joshajohnson/iCE40-feather/(threads)

Thread 1 (2023-09-19):

Looking for the assembly STEP model - can't find it.

paclogic, 2023-09-19:
If you would provide one or show a pointer to one that would be great.

joshajohnson, 2023-09-20:
Hi, you can export a STEP file from the KiCad project.

paclogic, 2023-10-13:
Josh, could you please post the STEP file in a directory so that i don't have to install and learn how to do it in KiCAD. Thank you very much !

Closed 2023-09-20.
