joshajohnson/iCE40-feather/hardware/0.1/iCE40-fpga.pdf

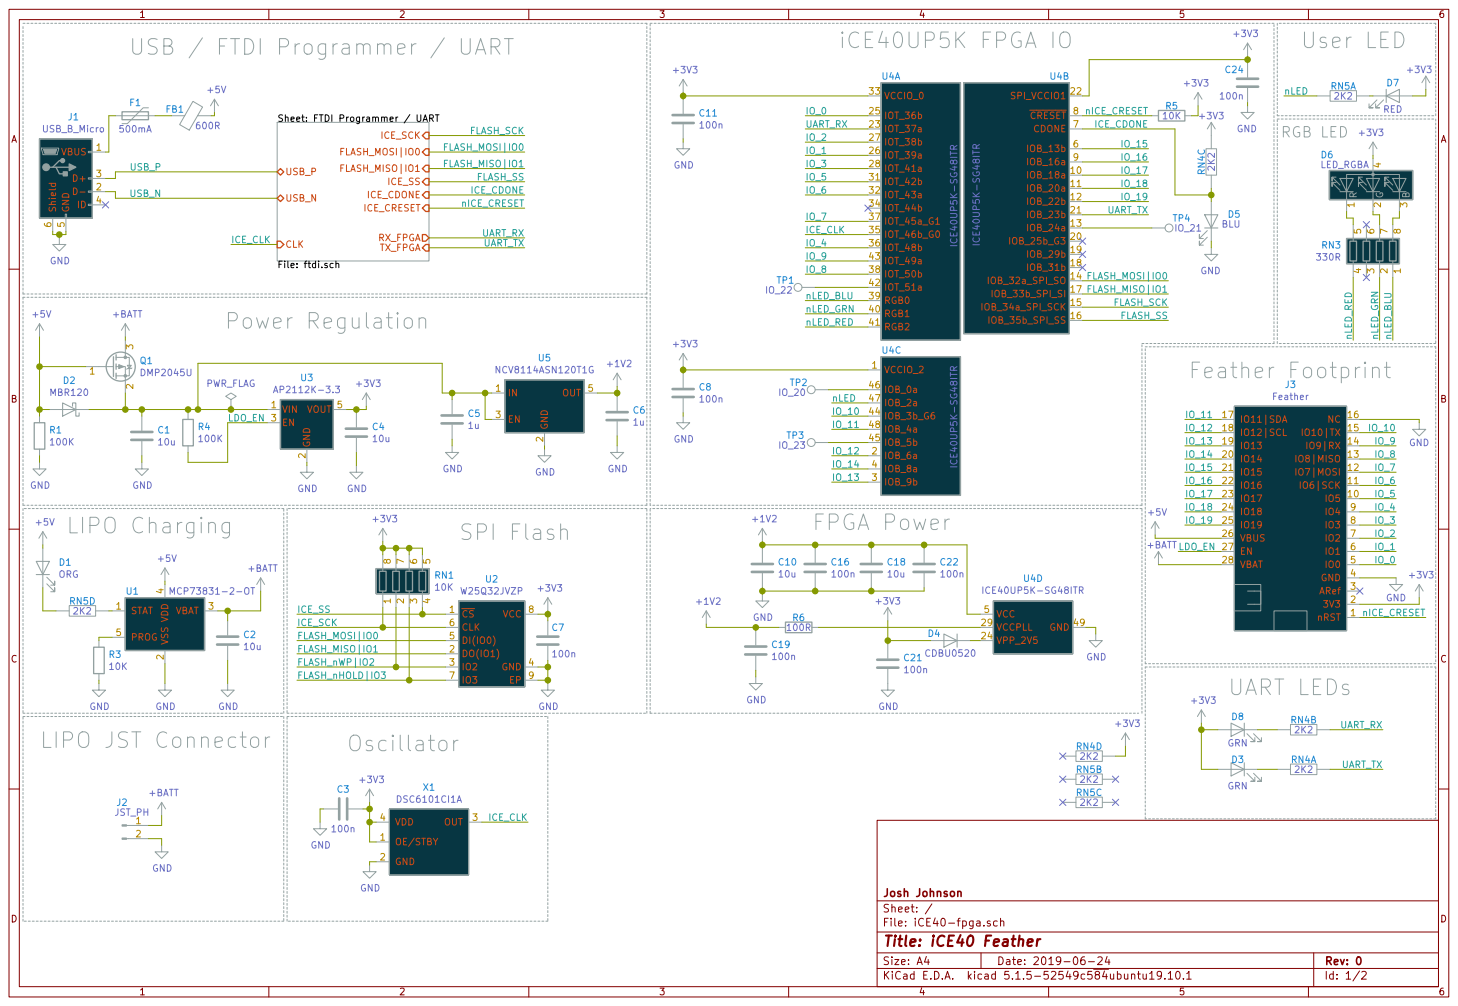
[picture p2: page 1]

USB / FTDI Programmer / UART

Sheet: FTDI Programmer / UART

4 PROG 5 U1 MCP73831-2-OT GND OE/STBY 1 GND 2 OUT 3 VDD 4 X1 DSC6101CI1A

File: iCE40-fpga.sch Sheet: / Josh Johnson

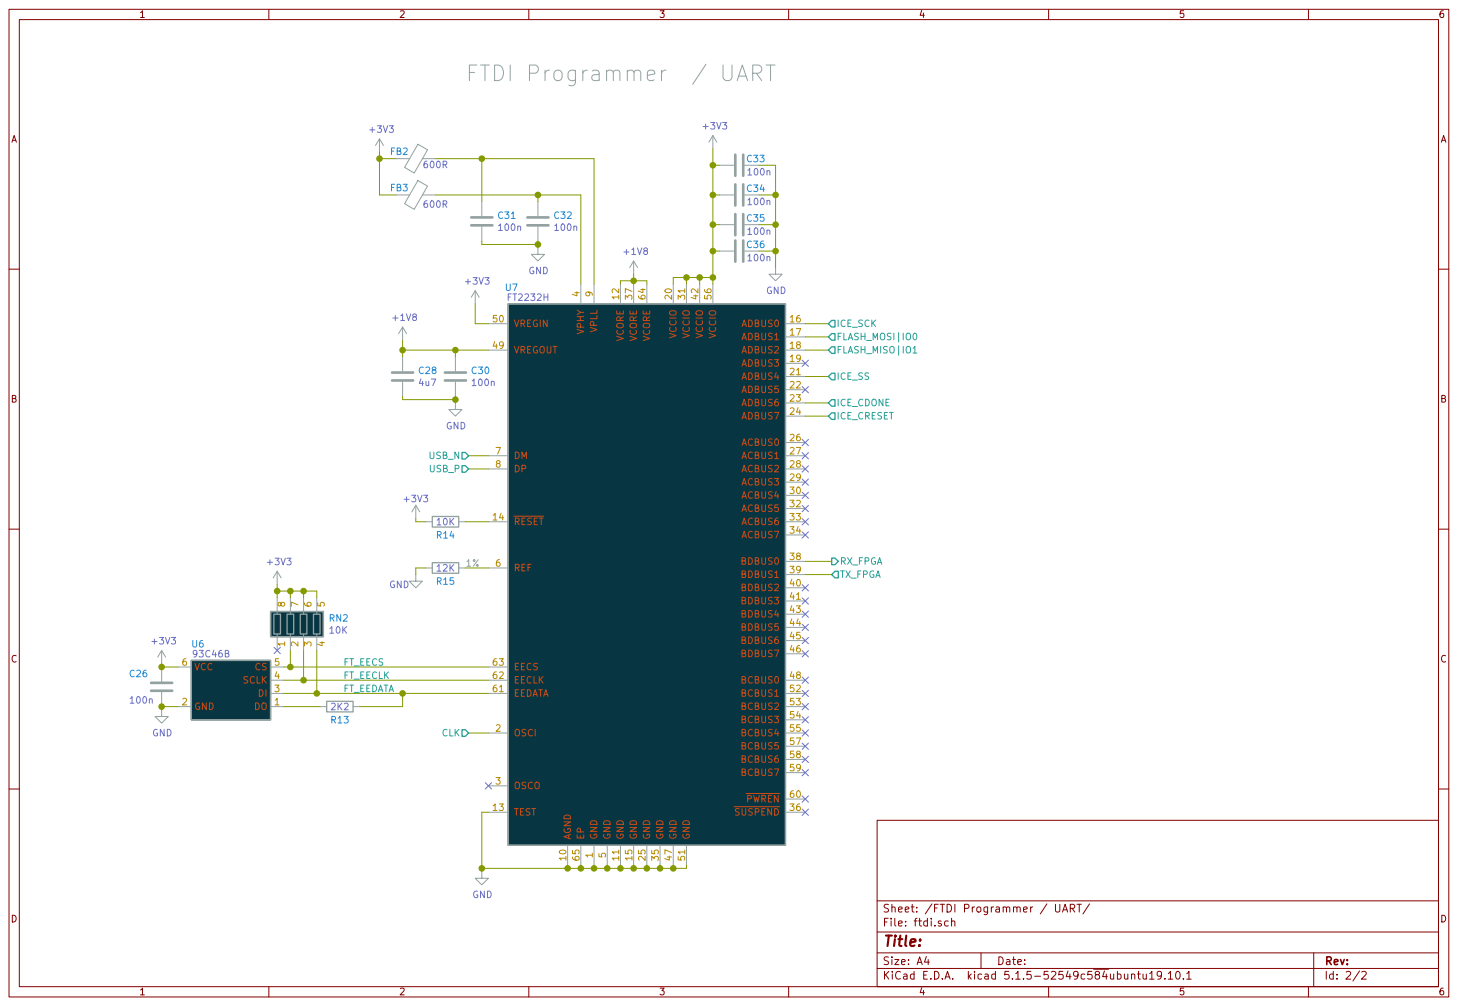
[picture p3: page 2]

ICE_CRESET USB_P CLK
Id: 2/2 Title: File: ftdi.sch Sheet: /FTDI Programmer / UART/ GND
