joshajohnson/iCE40-feather/hardware/0.2/outputs/iCE40-fpga.pdf

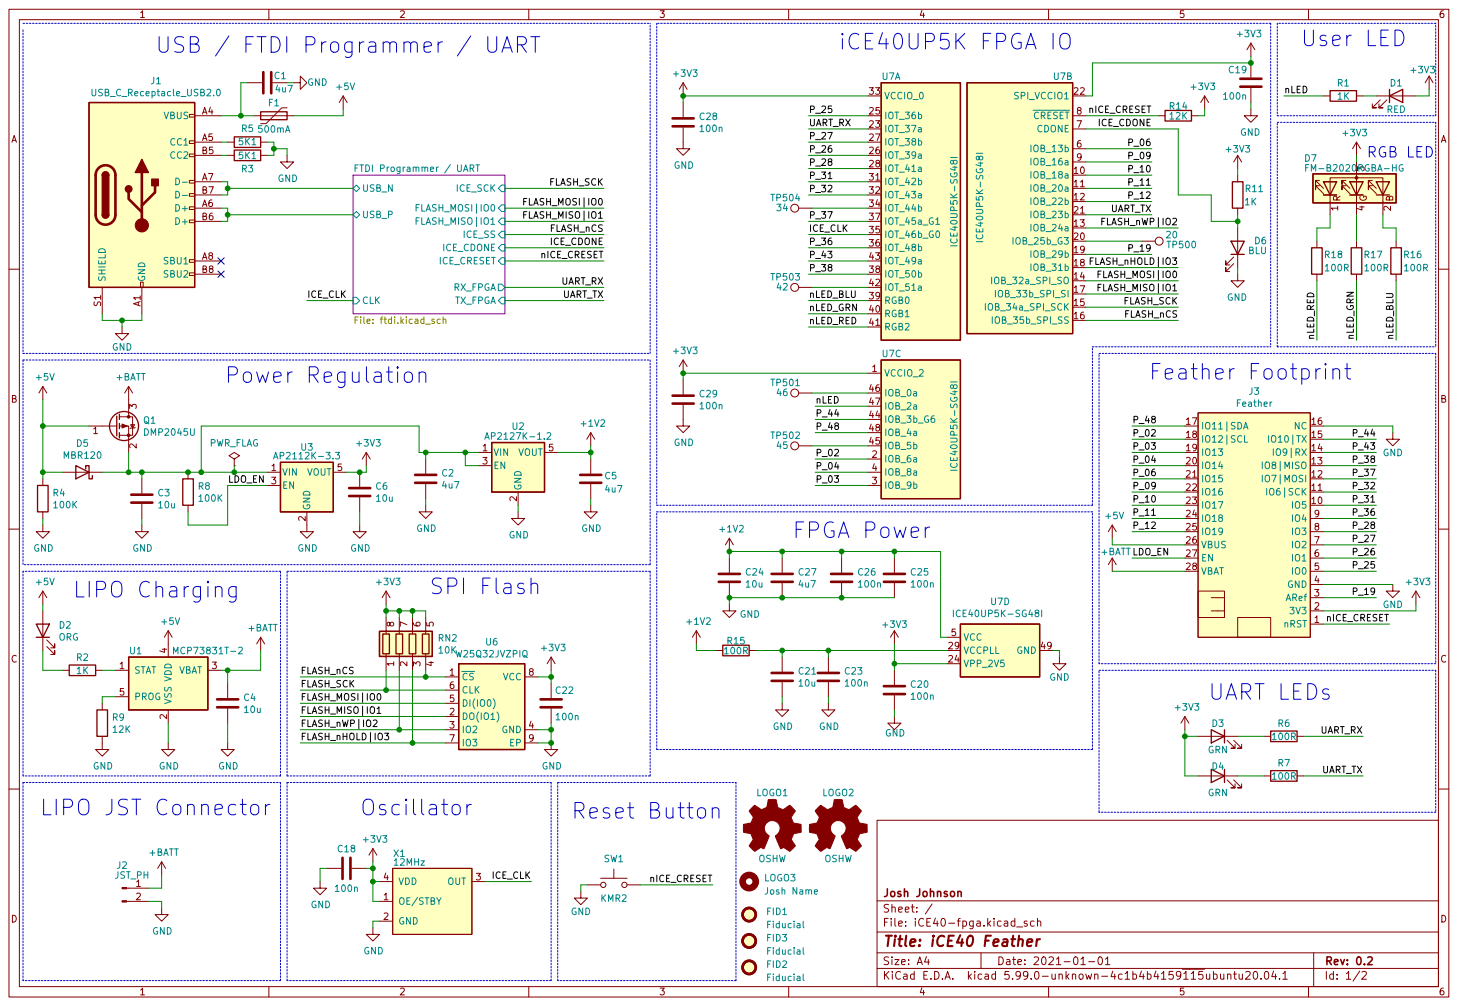
[picture p4: page 1]

USB / FTDI Programmer / UART

2 EN 3 VOUT 5 U2 AP2127K-1.2 GND GND

UART LEDs

File: iCE40-fpga.kicad_sch Sheet: / Josh Johnson

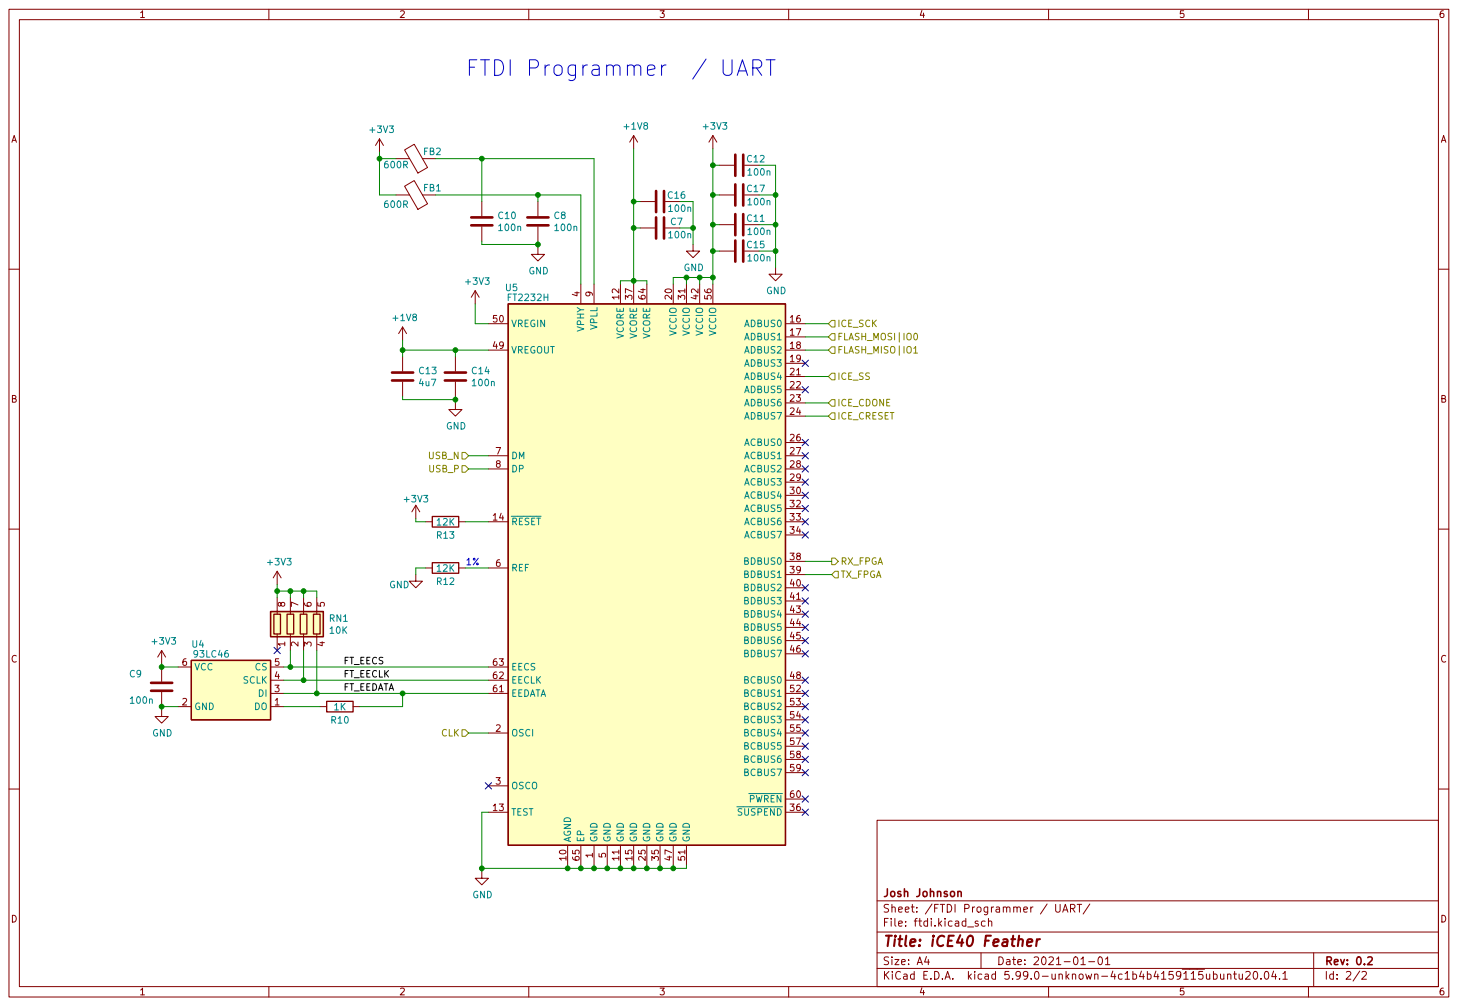
[picture p5: page 2]

Sheet: /FTDI Programmer / UART/ Josh Johnson
