joshajohnson/iCE40-feather/breakouts/7seg-dip-wing/7seg-dip-wing.pdf

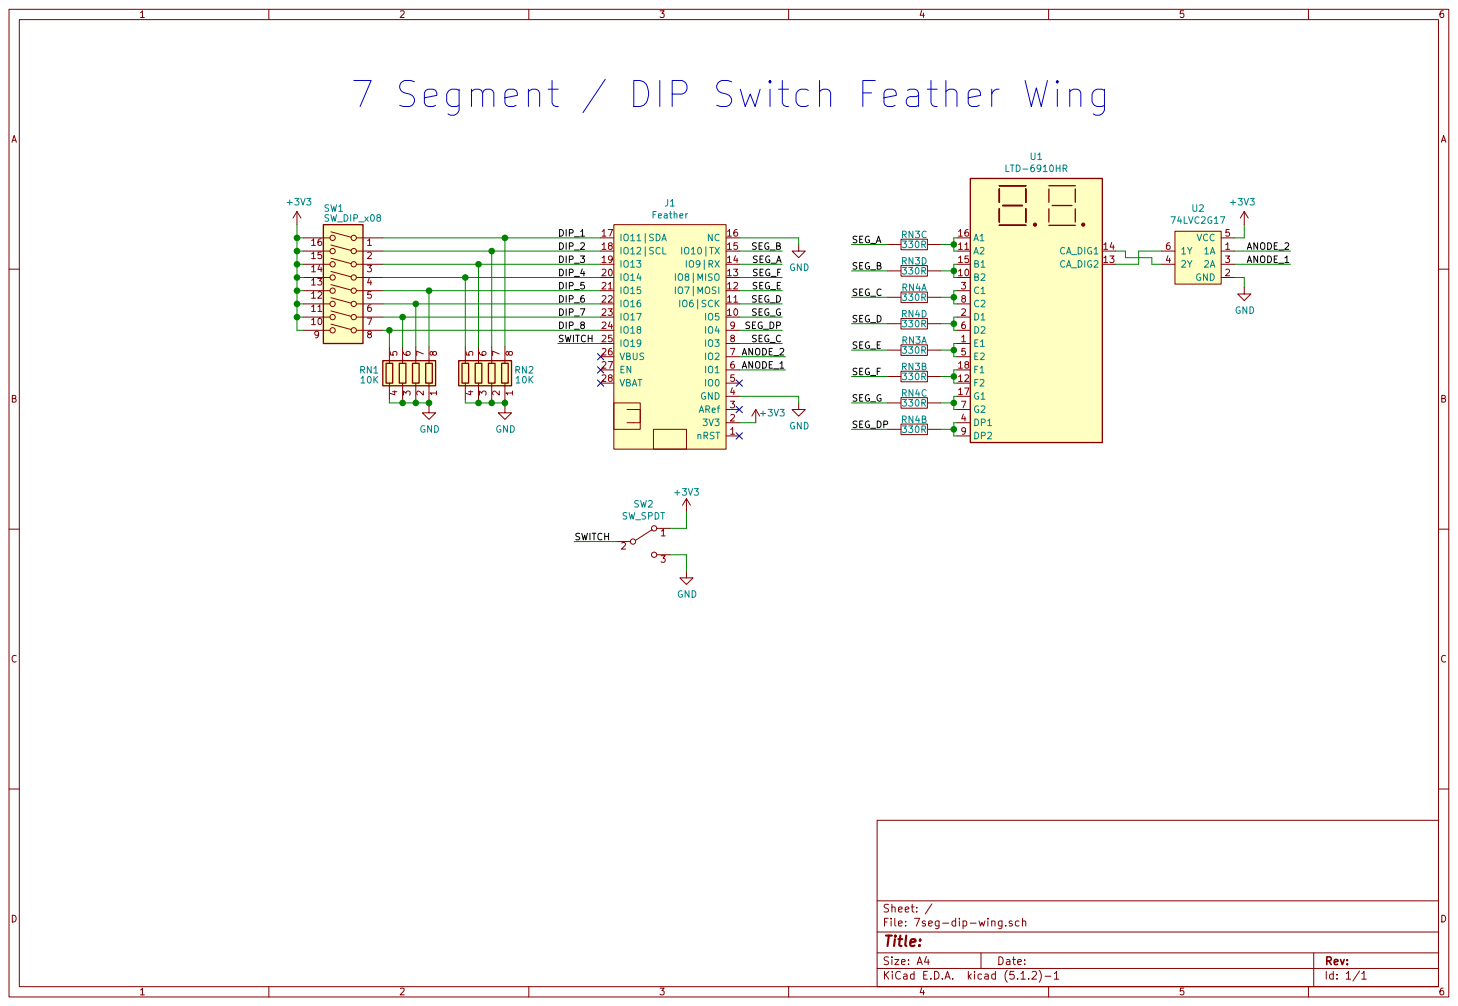
[picture p6: page 1]

SEG_G 7 Segment / DIP Switch Feather Wing

File: 7seg-dip-wing.sch Sheet: /
Id: 1/1 Title:
