joshajohnson/iCE40-feather/breakouts/led-wing/led-wing.pdf

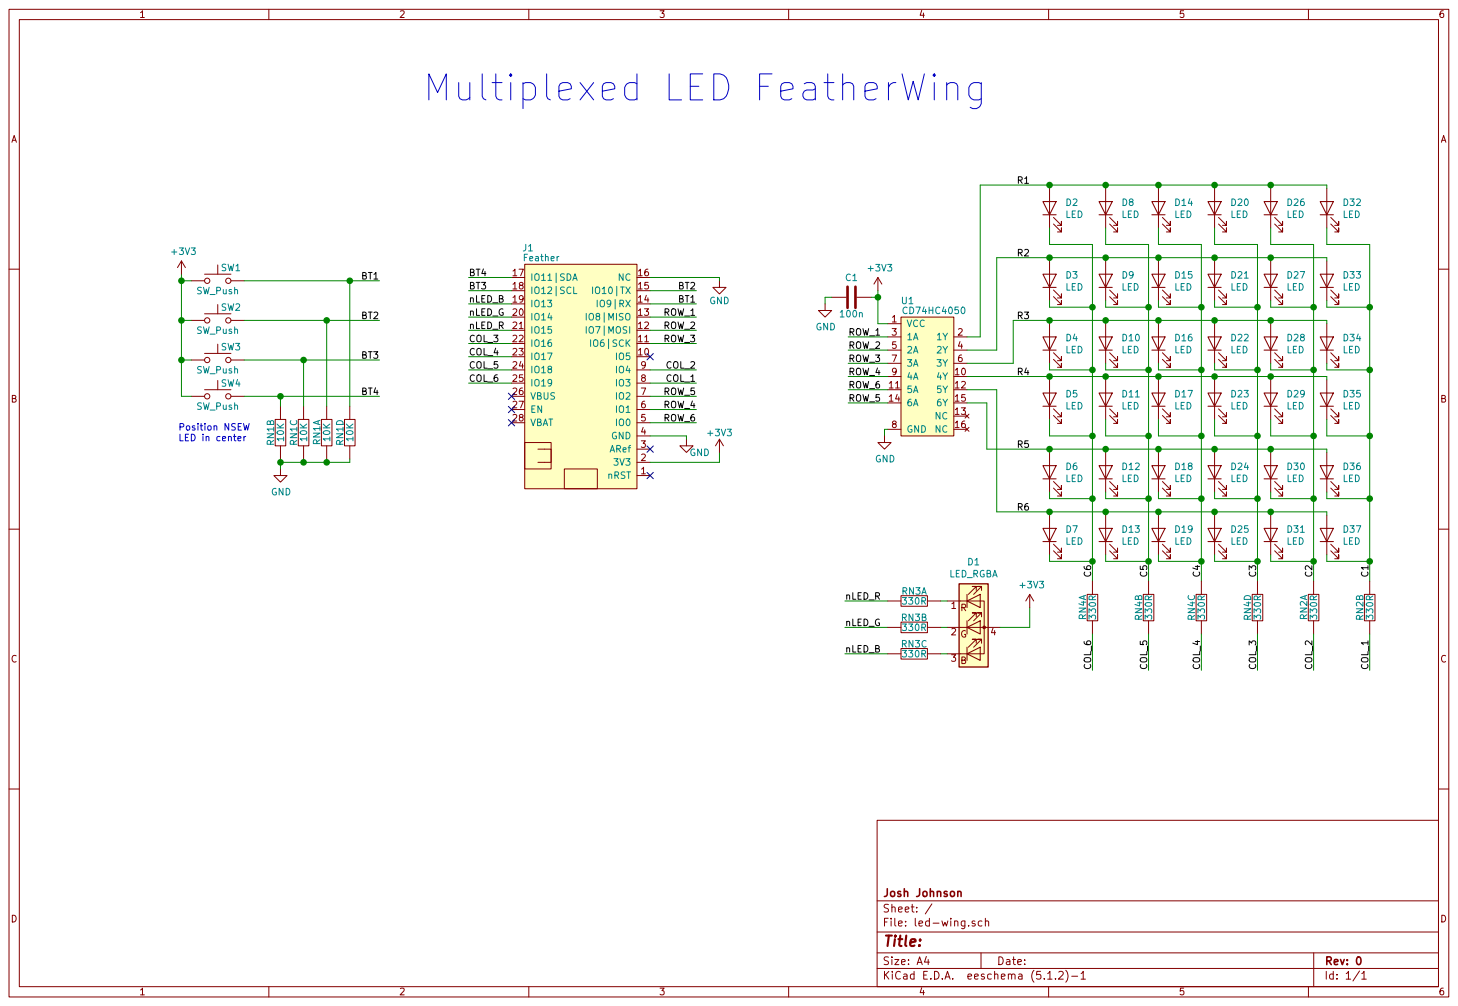
[picture p7: page 1]

ROW_1 ROW_2 ROW_3 ROW_4 ROW_5 ROW_6 COL_1 COL_2 +3V3 GNDGND Multiplexed LED FeatherWing

File: led-wing.sch Sheet: / Josh Johnson
