joshajohnson/iCE40-feather/breakouts/pmod-breakout/pmod-breakout.pdf

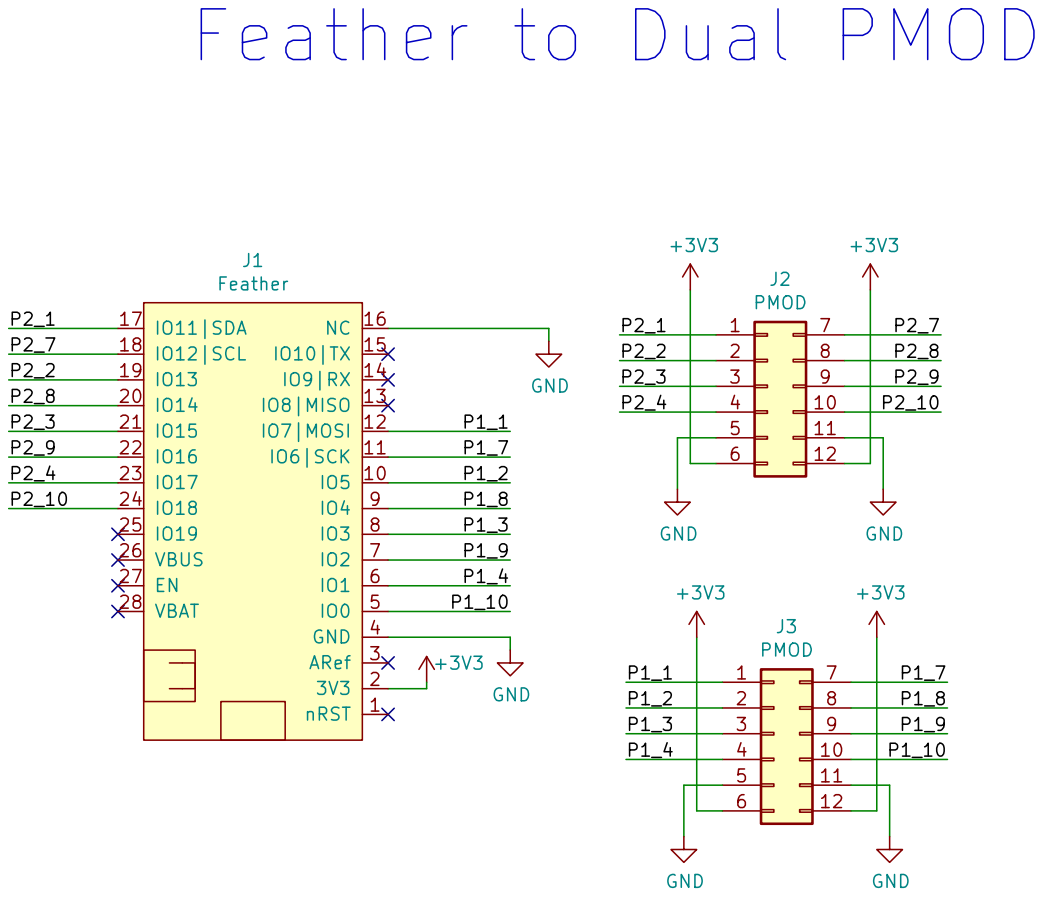
[picture p8: page 1]

File: pmod-breakout.sch Sheet: /
Id: 1/1 Title:
