joshajohnson/iCE40-feather/gateware/verilog/common/char_disp.v

`default_nettype none

module char_disp(
    input clk,
    input [7:0] data,
    output reg [35:0] img
);
	
	// Set img based upon ASCII input data
	always @(posedge clk) begin
		case (data)
		"A" : begin
			img [5:0] 	= 6'b111111;
			img [11:6] 	= 6'b100001;
			img [17:12] = 6'b100001;
			img [23:18] = 6'b111111;
			img [29:24] = 6'b100001;
			img [35:30] = 6'b100001;
		end

		"B" : begin
			img [5:0] 	= 6'b111110;
			img [11:6] 	= 6'b100001;
			img [17:12] = 6'b100001;
			img [23:18] = 6'b111110;
			img [29:24] = 6'b100001;
			img [35:30] = 6'b111110;
		end

		"C" : begin
			img [5:0] 	= 6'b111111;
			img [11:6] 	= 6'b100000;
			img [17:12] = 6'b100000;
			img [23:18] = 6'b100000;
			img [29:24] = 6'b100000;
			img [35:30] = 6'b111111;
		end

		"D" : begin
			img [5:0] 	= 6'b111110;
			img [11:6] 	= 6'b100001;
			img [17:12] = 6'b100001;
			img [23:18] = 6'b100001;
			img [29:24] = 6'b100001;
			img [35:30] = 6'b111110;
		end

		"E" : begin
			img [5:0] 	= 6'b111111;
			img [11:6] 	= 6'b100000;
			img [17:12] = 6'b100000;
			img [23:18] = 6'b111111;
			img [29:24] = 6'b100000;
			img [35:30] = 6'b111111;
		end

		"F" : begin
			img [5:0] 	= 6'b111111;
			img [11:6] 	= 6'b100000;
			img [17:12] = 6'b100000;
			img [23:18] = 6'b111111;
			img [29:24] = 6'b100000;
			img [35:30] = 6'b100000;
		end

		"G" : begin
			img [5:0] 	= 6'b111111;
			img [11:6] 	= 6'b100000;
			img [17:12] = 6'b100000;
			img [23:18] = 6'b100011;
			img [29:24] = 6'b100001;
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
			img [35:30] = 6'b000001;
		end

		"!" : begin
			img [5:0] 	= 6'b001100;
			img [11:6] 	= 6'b001100;
			img [17:12] = 6'b001100;
			img [23:18] = 6'b001100;
			img [29:24] = 6'b000000;
			img [35:30] = 6'b001100;
		end

		default : img = 36'd0;
		endcase

	end

endmodule
