joshajohnson/iCE40-feather/(commit log)

2021-01-09 add feather
    [bom.csv, ftdi.kicad_sch, ftdi.sch, iCE40-fpga.kicad_pcb, iCE40-fpga.kicad_sch, iCE40-fpga.sch]
2021-01-09 add breakout boards
    [7seg-dip-wing.kicad_pcb, 7seg-dip-wing.sch, led-wing.kicad_pcb, led-wing.sch, pmod-breakout.kicad_pcb, pmod-breakout.sch]
2021-01-16 update resistor values
    [bom.csv, ftdi.kicad_sch, iCE40-fpga.kicad_pcb, iCE40-fpga.kicad_sch]
2021-02-08 uart leds now 100R
    [bom.csv, ftdi.kicad_sch, iCE40-fpga.kicad_pcb, iCE40-fpga.kicad_sch]
